alx-sousa/Autonomous-IoT-Monitoring/hardware/README.md

# Hardware

| Revision | Controller | Status and files |
|---|---|---|
| [V1](rev1/README.md) | ESP32-C6 as reported | Historical integration, peripherals, GPIO mapping and report evidence |
| [REV 2.0](rev2/README.md) | XIAO ESP32-S3 intended | Receiver PCB; schematic, board documentation, Gerbers and component matching |

The presence of fabrication files does not establish assembly, electrical validation or firmware compatibility. See the [validation status](../docs/validation.md).
