alx-sousa/Autonomous-IoT-Monitoring/docs/images/20260716_211125.jpg

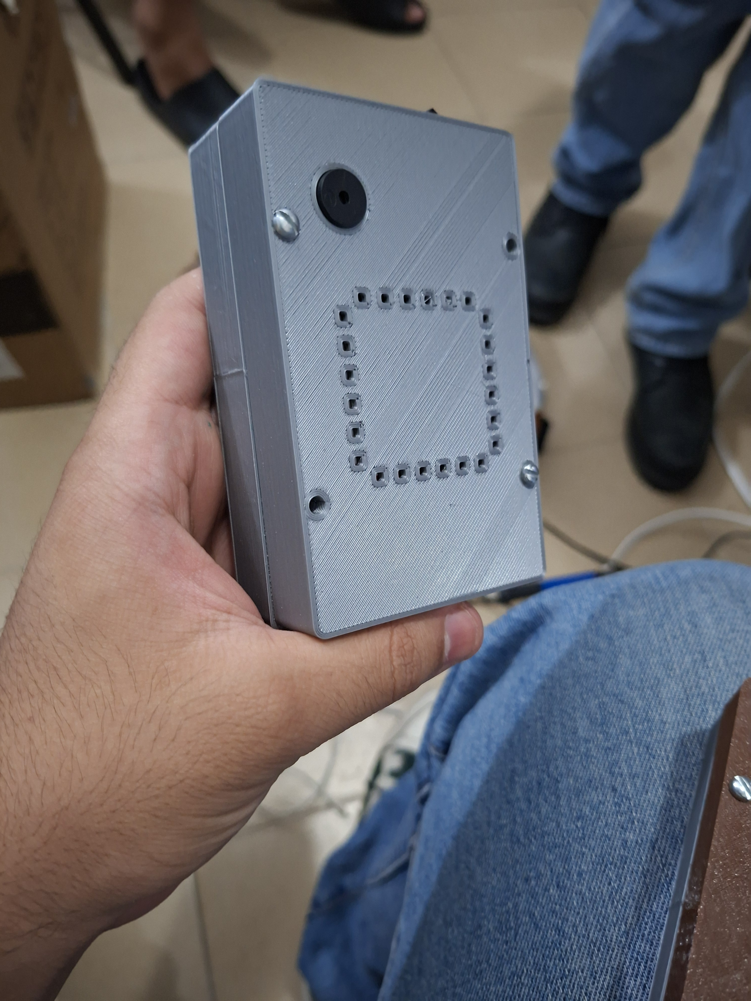
docs/images/20260716_211125.jpg
