alx-sousa/Autonomous-IoT-Monitoring/docs/images/20260716_211140.jpg

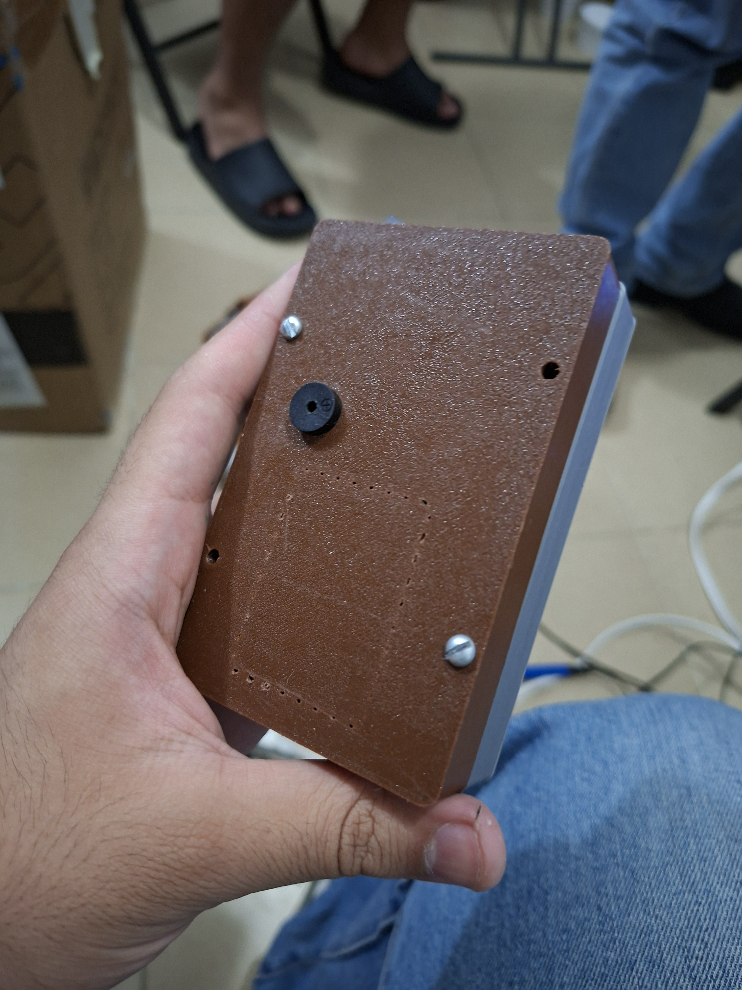
docs/images/20260716_211140.jpg
