alx-sousa/Autonomous-IoT-Monitoring/docs/images/20260717_100755~2.jpg

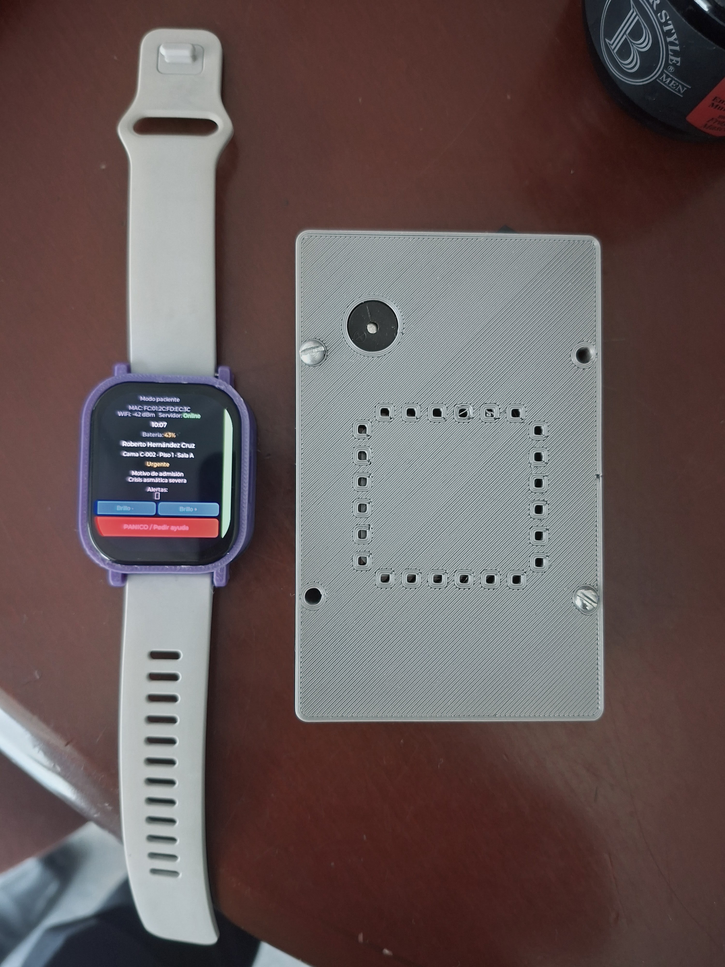
docs/images/20260717_100755~2.jpg
