alx-sousa/Autonomous-IoT-Monitoring/docs/images/architecture/system-architecture-v1-es.png

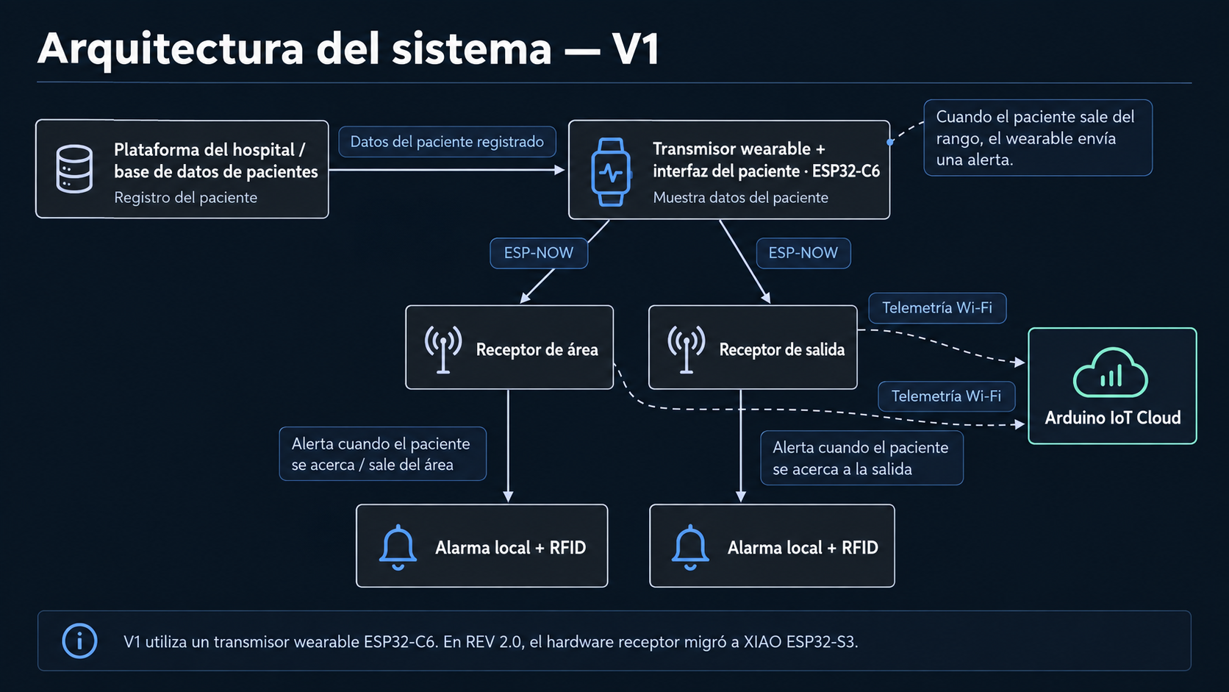
docs/images/architecture/system-architecture-v1-es.png
