alx-sousa/Autonomous-IoT-Monitoring/docs/images/rev2/pcb-bottom.png

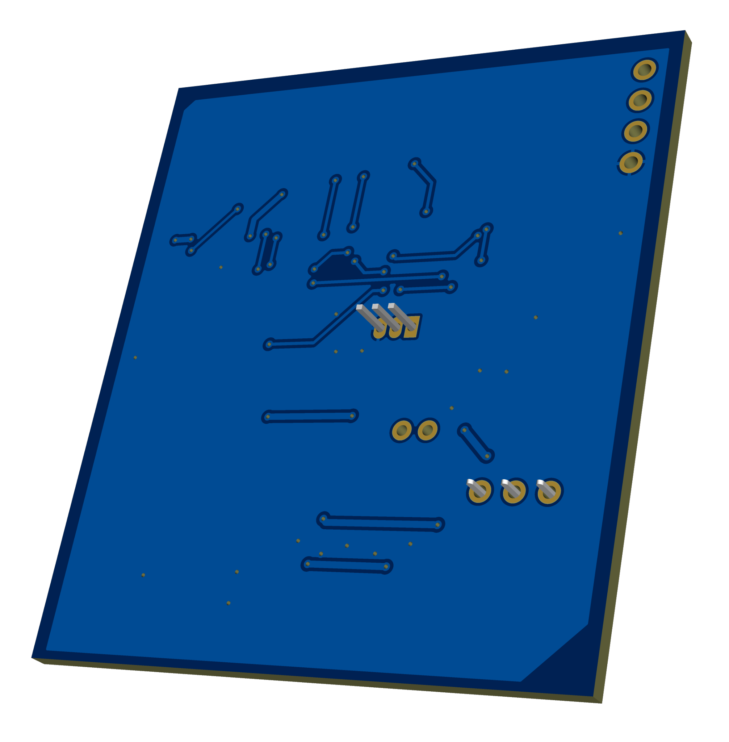
docs/images/rev2/pcb-bottom.png
