alx-sousa/Autonomous-IoT-Monitoring/hardware/rev2/bom/jlcpcb-matching-2026-09-24.xlsx

JLCPCB BOM Tool - BOM Matching
BOM name：1041c5ec480e4710936a3672ef2af2be_1790213198000-JLCPCB Assembly Order.xlsx |  |  | Download Time：2026-09-24 10:25:23 |  |  |  | * Our matching results are updated in real-time, but stock and prices may change. If it's been over 24 hours, please re-match before placing your order.
PCB Assembled Qty：5 |  |  | Est. Total Price：20.2370
Your BOM |  |  |  | Matched Parts |  |  |  |  |  |  | Order Information
Designator | Comment | Footprint | JLCPCB Part # | Matches | Part # | Manufacturer | Footprint | Description | Category | Warning | JLCPCB Part # | Product link | Lib Type | Qty | Source | Total Price ($)
BUZZER1 | 2.7kHz | BUZ-SMD_L9.0-W9.0_SMD-0955-42-27 |  | Select by System | SMD-9650-3327 | S&S | SMD,9.6x9.6mm | -20℃~+80℃ 2.7kHz 2V~5V 3.3V 30mA 5mm 80dB 9.6mm 9.6mm Active Buzzer (Built-in Driving Circuit) Electromagnetic SMD SMD,9.6x9.6mm Buzzers ROHS |  |  | C42420997 | https://jlcpcb.com/partdetail/SS-SMD_96503327/C42420997 | Extended | 5 | 5 JLCPCB | 2.1035
C1 | 100nF | C0603 |  | Select by System | 0603ZD104KAT2A | Kyocera AVX | 0603 | 100nF 10V X5R ±10% 0603 Multilayer Ceramic Capacitors MLCC - SMD/SMT ROHS | Multilayer Ceramic Capacitors MLCC - SMD/SMT |  | C1856507 | https://jlcpcb.com/partdetail/KyoceraAVX-0603ZD104KAT2A/C1856507 | Extended | 20 | 20 JLCPCB | 0.404
C2 | 10uF | C0603 |  | Select by System | 0603X106K100CT | Walsin Tech Corp | 0603 | 10uF X5R ±10% 0603 Multilayer Ceramic Capacitors MLCC - SMD/SMT ROHS | Multilayer Ceramic Capacitors MLCC - SMD/SMT |  | C2840513 | https://jlcpcb.com/partdetail/Walsin_TechCorp-0603X106K100CT/C2840513 | Extended | 20 | 20 JLCPCB | 0.988
CN1,CN3 | YTC1P-4015-01 | TESTPOINT-SMD_BD2.0-H5.5_YTC1P-4015-01 |  | Select by System | YTC1P-4015-01 | YIYUAN | SMD,D=2mm | 10000 times 100mΩ 12V 1P 2.5A 4.2mm 5.5mm Brass Gold Pogo Pin SMD,D=2mm Pogo Pin Spring Probe Connector ROHS | Pogo Pin Spring Probe Connector |  | C5221281 | https://jlcpcb.com/partdetail/YIYUAN-YTC1P_401501/C5221281 | Extended | 0 | 0 JLCPCB | 0
CN2 | PH-2AW | CONN-TH_2P-P2.00_HRO-CPH-2AW |  | Select by System | PH-2AW | Korean Hroparts Elec | 弯插,P=2mm | -25℃~+85℃ 1 1x2P 2 250V 2P 2mm 4.7mm 6.1mm 6.3mm Brass PA66 PH Right Angle Push-Pull,P=2mm Wire To Board Connector ROHS | Wire To Board Connector |  | C22360303 | https://jlcpcb.com/partdetail/Korean_HropartsElec-PH2AW/C22360303 | Extended | 5 | 5 JLCPCB | 0.2295
D1 | 1N4148W | SOD-123_L2.7-W1.6-LS3.7-FD |  | Select by System | 1N4148W | hongjiacheng | SOD-123 | -55℃~+150℃ 1.25V@150mA 100V 150mA 1uA@75V 2A 400mW 4ns Independent SOD-123 Switching Diodes ROHS | Switching Diodes |  | C7420318 | https://jlcpcb.com/partdetail/hongjiacheng-1N4148W/C7420318 | Extended | 15 | 15 JLCPCB | 0.105
OLED1 | HS91L02W2C01 | OLED-TH_L38.0-W12.0_HS91L02W2C01 |  | Select by System | HS91L02W2C01 | HS | - | 0.91 1.65V~3.3V 128x32 150cd/m2 22.384x5.584mm I2C Passive (PMOLED) SSD1306 chip White - OLED Display ROHS | OLED Display |  | C5248081 | https://jlcpcb.com/partdetail/HS-HS91L02W2C01/C5248081 | Extended | 5 | 5 JLCPCB | 11.6385
Q1 | BC547 | TO-92-3_L4.9-W3.7-P1.27-L |  | Select by System | BC547 | Jiangsu Changjing Electronics Technology Co., Ltd. | TO-92 | -55℃~+150℃ 1 NPN 100mA 100nA 150MHz 300mV 45V 625mW 6V 800 NPN Standalone TO-92 Bipolar (BJT) ROHS | Bipolar (BJT) |  | C47089404 | https://jlcpcb.com/partdetail/49277194-BC547/C47089404 | Extended | 7 | 7 JLCPCB | 0.2695
R2 | 10K | R0603 |  | Unconfirmed | 0603WAF1002T5E | UNI-ROYAL(Uniroyal Elec) | 0603 | -55℃~+155℃ 100mW 10kΩ 75V Thick Film Resistor ±1% ±100ppm/℃ 0603 Chip Resistor - Surface Mount ROHS | Chip Resistor - Surface Mount | 1.The comment (0603WAF1002T5E) of this part does not match the one (10K) provided in your BOM. Please confirm; | C25804 | https://jlcpcb.com/partdetail/26547-0603WAF1002T5E/C25804 | Basic | 5 | 5 JLCPCB | 0.009
R3,R4,R5 | 330R | R0603 |  | Unconfirmed | 0603WAF3300T5E | UNI-ROYAL(Uniroyal Elec) | 0603 | -55℃~+155℃ 100mW 330Ω 75V Thick Film Resistor ±1% ±100ppm/℃ 0603 Chip Resistor - Surface Mount ROHS | Chip Resistor - Surface Mount | 1.The comment (0603WAF3300T5E) of this part does not match the one (330R) provided in your BOM. Please confirm; | C23138 | https://jlcpcb.com/partdetail/23865-0603WAF3300T5E/C23138 | Basic | 15 | 15 JLCPCB | 0.039
R6 | 1K | R0603 |  | Unconfirmed | 0603WAF1001T5E | UNI-ROYAL(Uniroyal Elec) | 0603 | -55℃~+155℃ 100mW 1kΩ 75V Thick Film Resistor ±1% ±100ppm/℃ 0603 Chip Resistor - Surface Mount ROHS | Chip Resistor - Surface Mount | 1.The comment (0603WAF1001T5E) of this part does not match the one (1K) provided in your BOM. Please confirm; | C21190 | https://jlcpcb.com/partdetail/21904-0603WAF1001T5E/C21190 | Basic | 5 | 5 JLCPCB | 0.013
SW1 | TS-1187A-B-A-B | SW-SMD_4P-L5.1-W5.1-P3.70-LS6.5-TL_H1.5 |  | Select by System | TS-1187A-B-A-B | XKB Connection | SMD-4P,5.1x5.1mm | -30℃~+85℃ 1.5mm 1.6N 100,000 cycles 12V 5.1mm 5.1mm 50mA Gold No Round Button SPST Surface Mount,Vertical Without Bracket SMD-4P,5.1x5.1mm Tactile Switches ROHS | Tactile Switches |  | C318884 | https://jlcpcb.com/partdetail/XKBConnection-TS_1187A_B_AB/C318884 | Basic | 5 | 5 JLCPCB | 0.1025
U4 | SZYY0603RGB-B | LED-SMD_4P-L1.6-W1.5-SZYY0603RGB-B |  | Select by System | SZYY0603RGB-B | Yongyu Photoelectric | SMD | -40℃~+85℃ 0.6mm 1.5mm 1.6mm 120° G:525nm、B:470nm、R:638nm G:70mW、B:70mW、R:48mW R:1.9V~2.3V、G:2.6V~3.0V、B:2.7V~3.1V R:120mcd~180mcd、G:200mcd~392mcd、B:60mcd~85mcd R:20mA、G:20mA、B:20mA R:620nm~625nm、G:525nm~533nm、B:468nm~476nm Water Clear SMD RGB LEDs ROHS |  |  | C434430 | https://jlcpcb.com/partdetail/YongyuPhotoelectric-SZYY0603RGBB/C434430 | Extended | 10 | 10 JLCPCB | 0.314
U5,U6 | HXPM2.54-1x7PTP-YQ | HDR-SMD_7P-P2.54_HX-PM2.54-1X7P-TP-YQ |  | Select by System | HX PM2.54-1x7P TP-YQ | hanxia | SMD,P=2.54mm(交错脚) | SMD,P=2.54mm(Staggered pins) Female Headers ROHS | Female Headers |  | C42379199 | https://jlcpcb.com/partdetail/hanxia-HX_PM2_54_1x7P_TPYQ/C42379199 | Extended | 10 | 10 JLCPCB | 2.928
U7 | HXPM2.54-1x4PTP-YQ | HDR-SMD_HX-PM2.54-1X4P-TP-YQ |  | Select by System | HX PM2.54-1x4P TP-YQ | hanxia | SMD,P=2.54mm(交错脚) | -40℃~+105℃ 1 1x4P 2.54mm 3A 4P 5mm Gold Square Hole Surface Mount,Vertical Top SMD,P=2.54mm(Staggered pins) Female Headers ROHS | Female Headers |  | C42379197 | https://jlcpcb.com/partdetail/hanxia-HX_PM2_54_1x4P_TPYQ/C42379197 | Extended | 5 | 5 JLCPCB | 1.0935
U3 | SS12D00G4 | SW-TH_SS12D00G4 |  | No matches | No Part Selected
