alx-sousa/Autonomous-IoT-Monitoring/hardware/rev2/schematic/schematic-2026-09-23.pdf

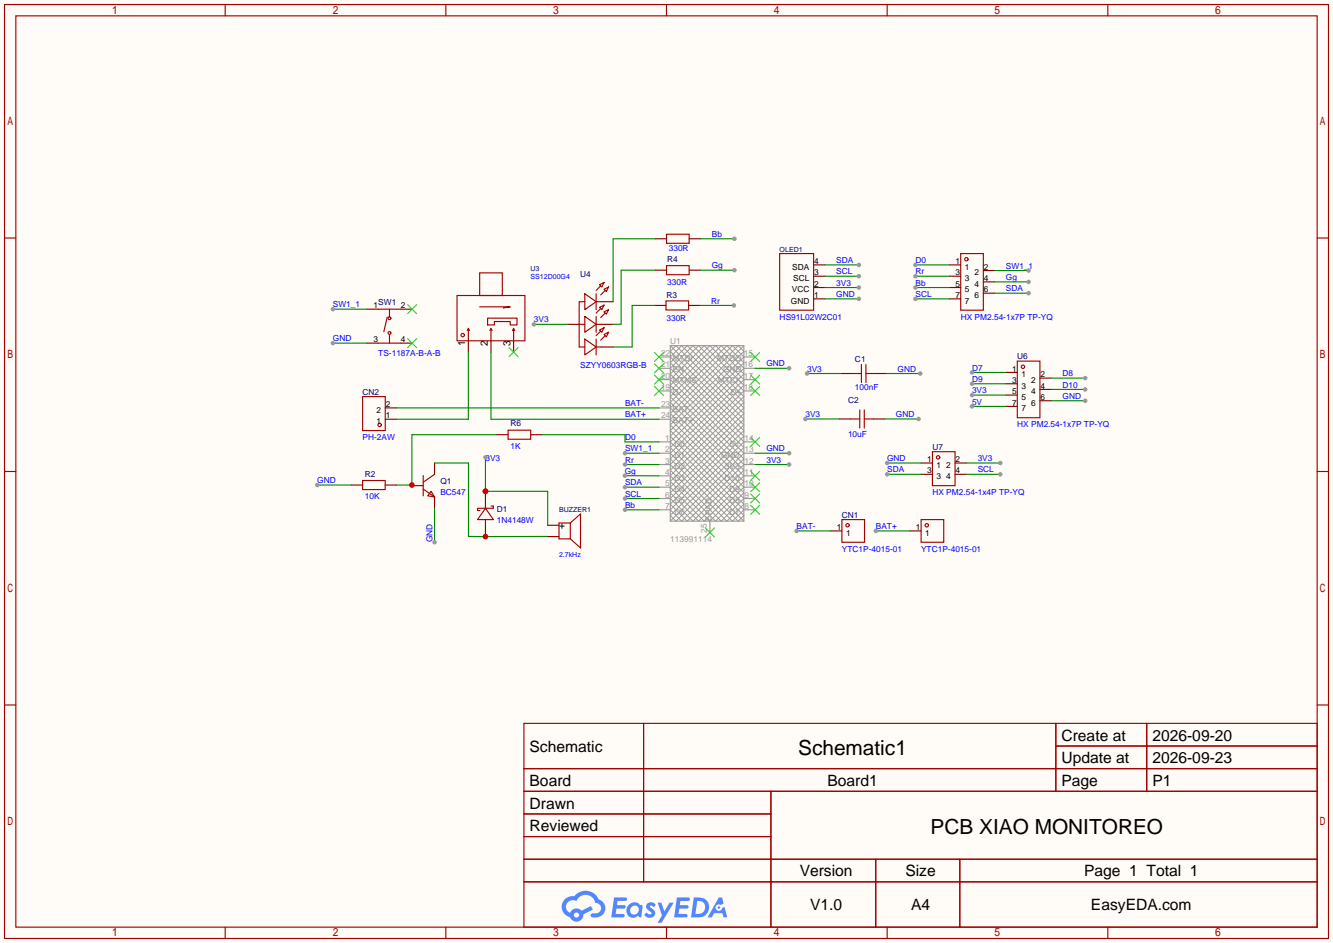
[picture p18: page 1]

Schematic | Schematic1 | Create at | 2026-09-20

Update at | 2026-09-23

Board | Board1 | Page | P1
Drawn | | PCB XIAO MONITOREO
Reviewed

Version | Size | Page 1 Total 1
V1.0 | A4 | EasyEDA.com
