alx-sousa/Autonomous-IoT-Monitoring/hardware/rev2/pcb/pcb-documentation-2026-09-23.pdf

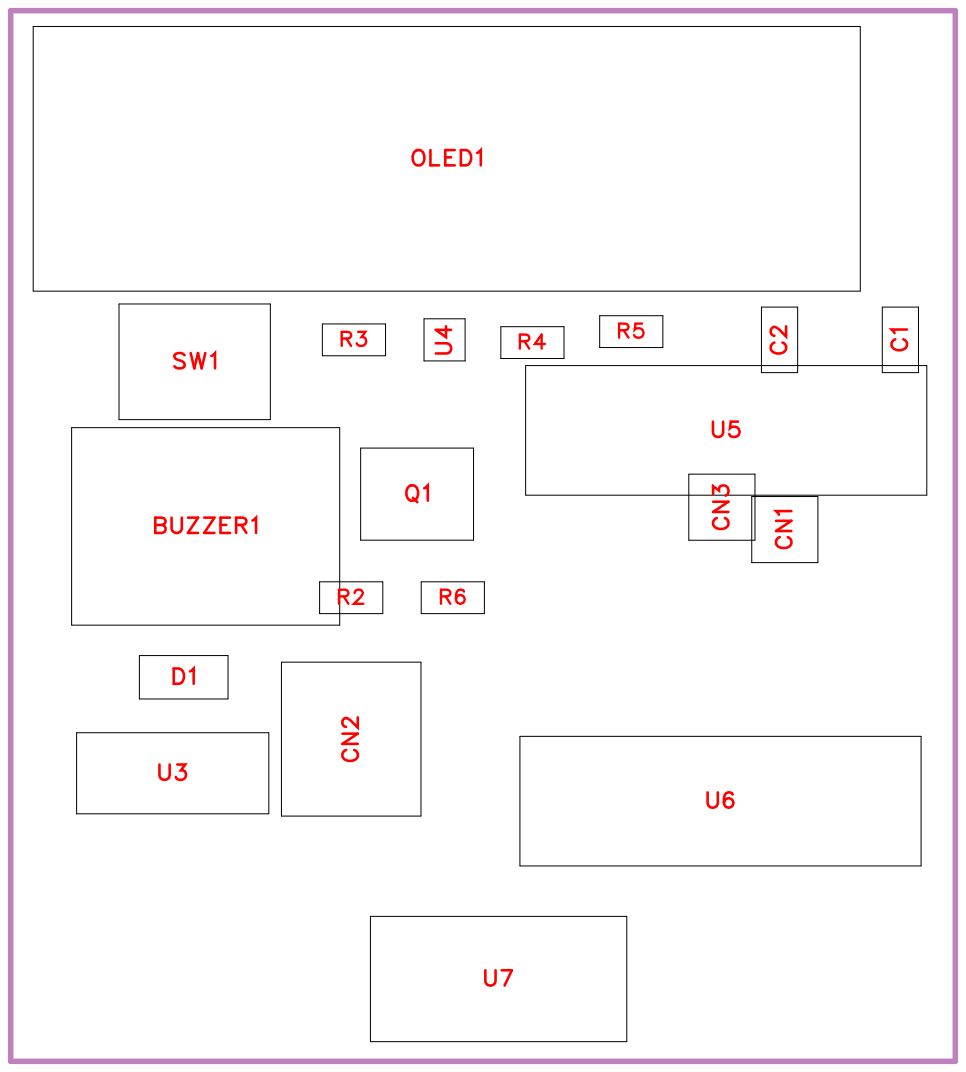
[picture p19: page 1]

No. | Quantity | Comment | Designator | Footprint | Value | Manufacturer Part | Manufacturer | Supplier Part | Supplier
1 | 1 | 2.7kHz | BUZZER1 | BUZ-SMD_L 9.0-W9.0_S MD-0955-42-27 | 2.7kHz | SMD-9650-3 327 | S&S(海旭 ) | C42420997 | LCSC
2 | 1 | 100nF | C1 | C0603 | 100nF | 0603ZD104K AT2A | Kyocera AVX | C1856507 | LCSC
3 | 1 | 10uF | C2 | C0603 | 10uF | 0603X106K1 00CT | Walsin(华新 科) | C2840513 | LCSC
4 | 2 | YTC1P-4015 -01 | CN1,CN3 | TESTPOINT-SMD_BD2.0-H5.5_YTC1P -4015-01 | | YTC1P-4015 -01 | YIYUAN(怡远 ) | C5221281 | LCSC
5 | 1 | PH-2AW | CN2 | CONN-TH_2 P-P2.00_HR O-CPH-2AW | | PH-2AW | 韩国韩荣 | C22360303 | LCSC
6 | 1 | 1N4148W | D1 | SOD-123_L2 .7-W1.6-LS3. 7-FD | | 1N4148W | R+O(宏嘉诚 ) | C7420318 | LCSC
7 | 1 | HS91L02W2 C01 | OLED1 | OLED-TH_L3 8.0-W12.0_H S91L02W2C 01 | | HS91L02W2 C01 | HS(汉昇 ) | C5248081 | LCSC
8 | 1 | BC547 | Q1 | TO-92-3_L4. 9-W3.7-P1.2 7-L | | BC547 | CJ(江苏长电 / 长晶 ) | C47089404 | LCSC
9 | 1 | 10K | R2 | R0603 | 10K
10 | 3 | 330R | R3,R4,R5 | R0603 | 330R
11 | 1 | 1K | R6 | R0603 | 1K
12 | 1 | TS-1187A-B-A-B | SW1 | SW-SMD_4P -L5.1-W5.1-P 3.70-LS6.5-T L_H1.5 | | TS-1187A-B-A-B | XKB Connect ion(中国星坤 ) | C318884 | LCSC
13 | 1 | SS12D00G4 | U3 | SW-TH_SS1 2D00G4 | | SS12D00G4 | YIZHI(逸致 ) | C50377148 | LCSC
14 | 1 | SZYY0603R GB-B | U4 | LED-SMD_4 P-L1.6-W1.5-SZYY0603R GB-B | | SZYY0603R GB-B | yongyu(永裕 光电 ) | C434430 | LCSC
15 | 2 | HX PM2.54-1x7P TP-YQ | U5,U6 | HDR-SMD_7 P-P2.54_HX-PM2.54-1X7 P-TP-YQ | | HX PM2.54-1x7P TP-YQ | hanxia(韩下 ) | C42379199 | LCSC
16 | 1 | HX PM2.54-1x4P TP-YQ | U7 | HDR-SMD_H X-PM2.54-1X 4P-TP-YQ | | HX PM2.54-1x4P TP-YQ | hanxia(韩下 ) | C42379197 | LCSC

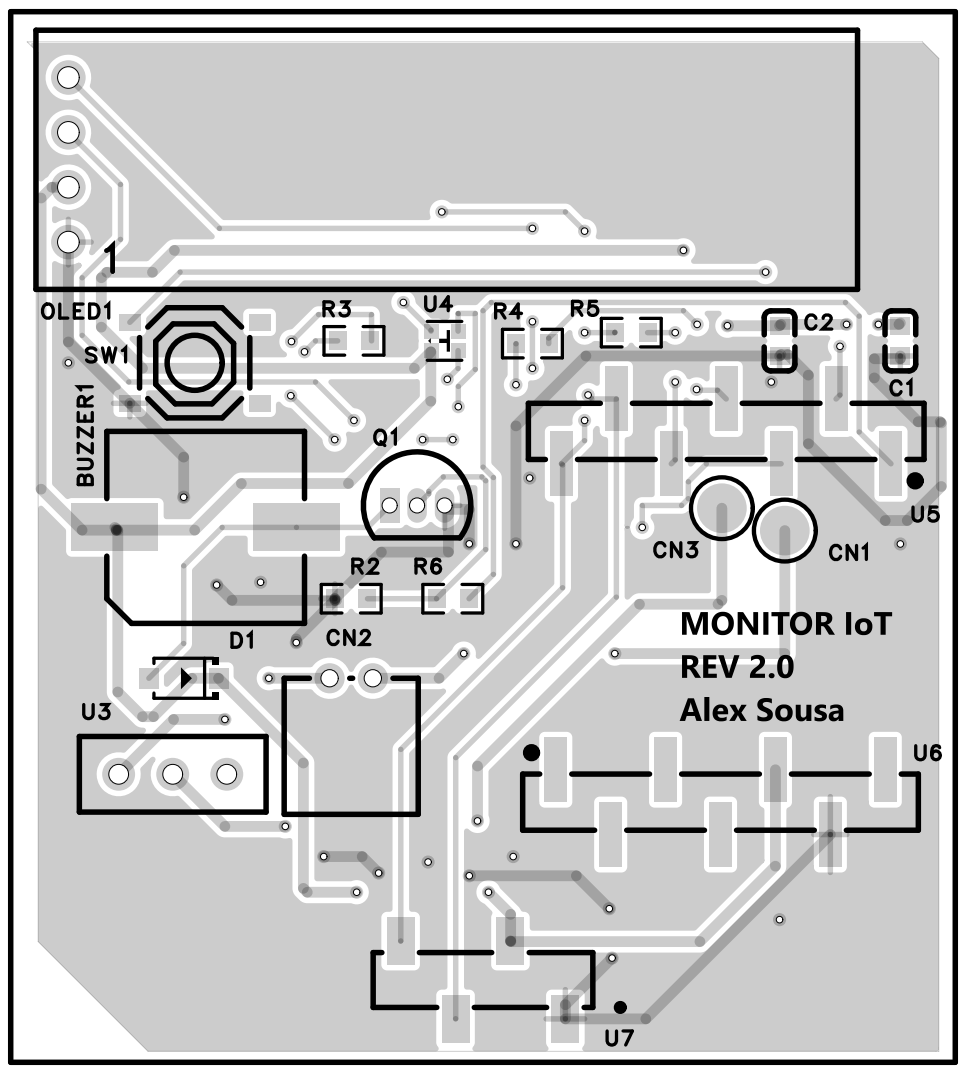
[picture p20: page 4]

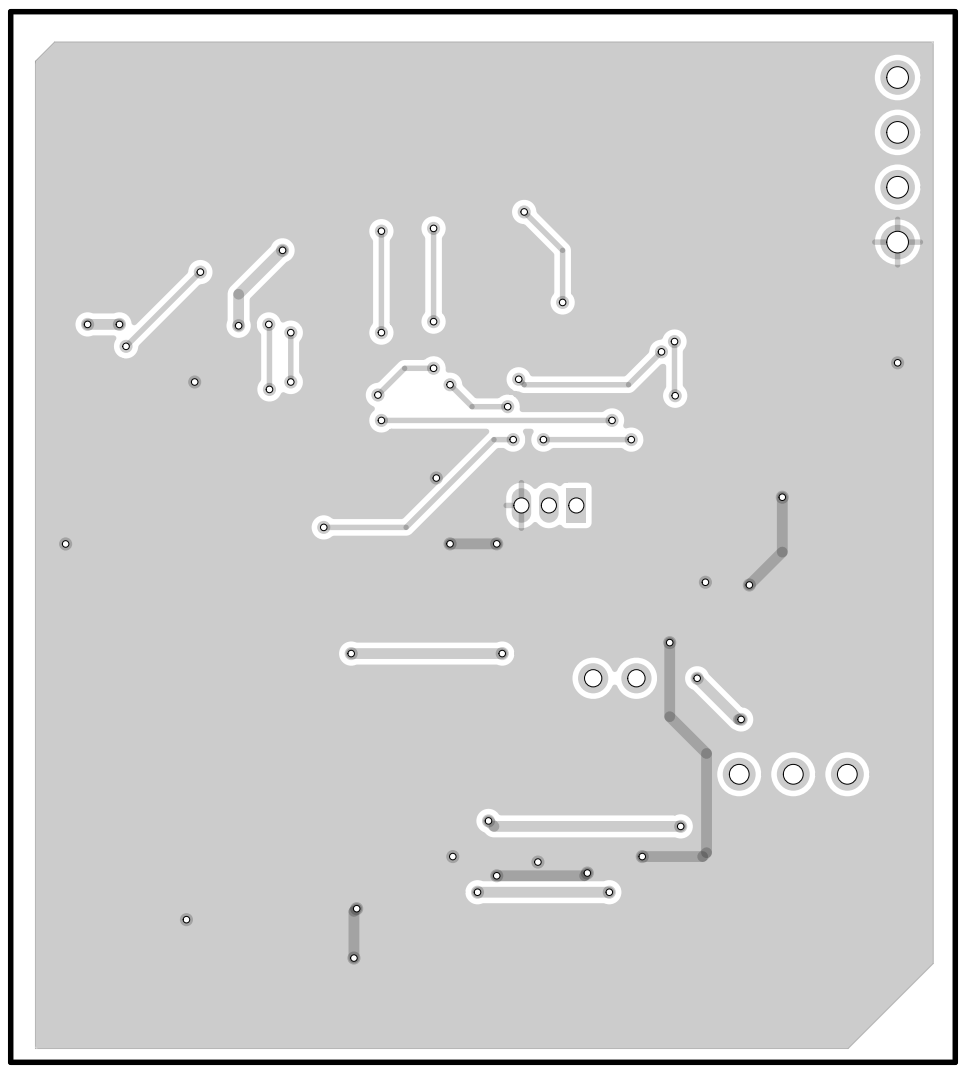
[picture p21: page 5]

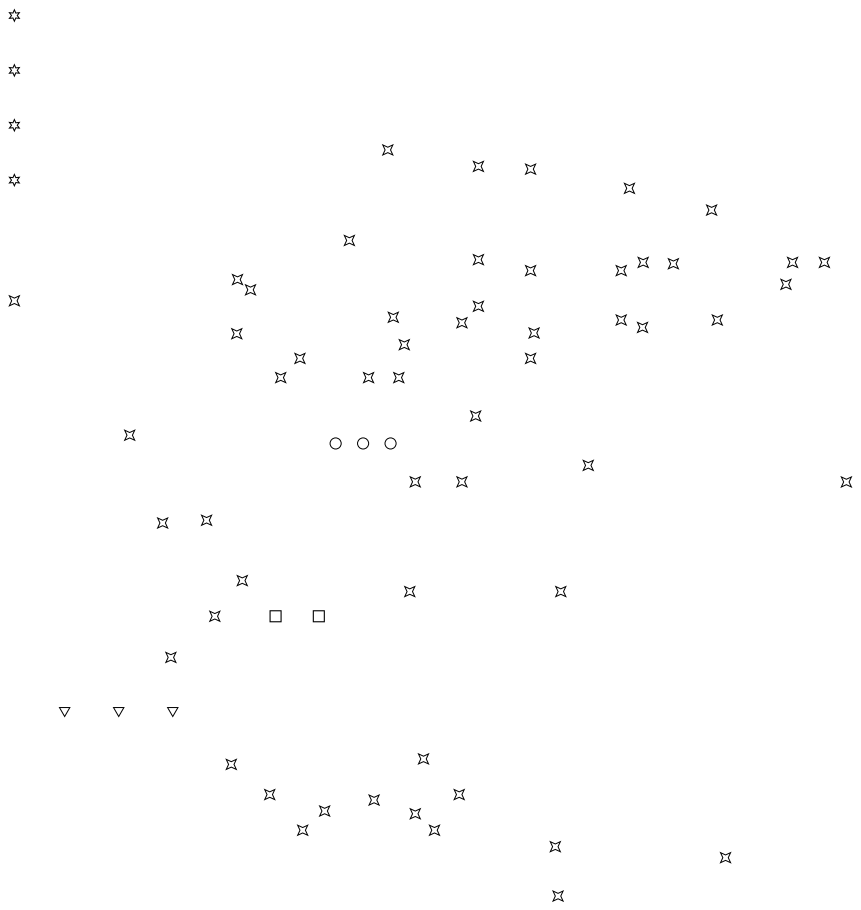
[picture p22: page 6]
