alx-sousa/Autonomous-IoT-Monitoring/(commit log)

2026-09-20 docs: add measured prototype testing results
2026-09-20 docs: add hardware BOM and connection reference
2026-09-20 docs: add integrated prototype gallery
2026-09-23 docs: present V1 engineering portfolio with residency evidence
    Refresh Spanish README and add English overview, objectives, design decisions,
    setup instructions and a source-aware review of reported results.
    Add six technical figures; preserve all original prototype images.
    Consolidate firmware, remove credential-bearing root duplicates and restore
    the missing Cloud connection declaration. Document credential rotation.
2026-09-24 docs: add rev2 hardware artifacts and engineering documentation
    [jlcpcb-matching-2026-09-24.xlsx]
2026-09-25 Reframe historical testing around delivered V1 prototype
2026-09-26 docs: document REV 2.0 Fusion assembly in Spanish
2026-09-26 docs: add Fusion 360 mechanical assembly decisions
2026-09-26 docs: add REV 2.0 mechanical assembly evidence notes
2026-09-26 docs: link REV 2.0 PCB hardware portfolio
2026-09-26 docs: add REV 2.0 Fusion 360 assembly visual
2026-09-26 docs: add Fusion 360 assembly visual to Spanish README
2026-09-26 docs: include Fusion 360 mechanical assembly evidence
2026-09-27 docs: add final REV 2.0 enclosure CAD
2026-09-27 docs: mark REV 2.0 enclosure CAD complete
2026-09-27 docs: document completed REV 2.0 enclosure CAD
2026-09-27 docs: close REV 2.0 mechanical CAD stage
2026-09-27 docs: add final REV 2.0 enclosure CAD evidence
2026-09-27 docs: update REV 2.0 mechanical CAD status
2026-09-27 chore: remove incorrect REV 2.0 enclosure CAD image
2026-09-27 chore: rename final REV 2.0 enclosure CAD image
2026-09-27 docs: fix final REV 2.0 enclosure CAD image path
2026-09-28 docs: highlight wearable transmitter patient interface
2026-09-28 Rename Imagen de ChatGPT 27 sept 2026, 10_58_44 p.m..png to wearable-transmitter-v1.jpg
2026-09-28 docs: replace public firmware source with block-level architecture
    [transmitter.ino]
2026-10-20 docs: document V1 transmitter control flow
2026-10-20 docs: surface firmware review in Spanish landing page
