alx-sousa/Autonomous-IoT-Monitoring/docs/images/20260716_211158.jpg

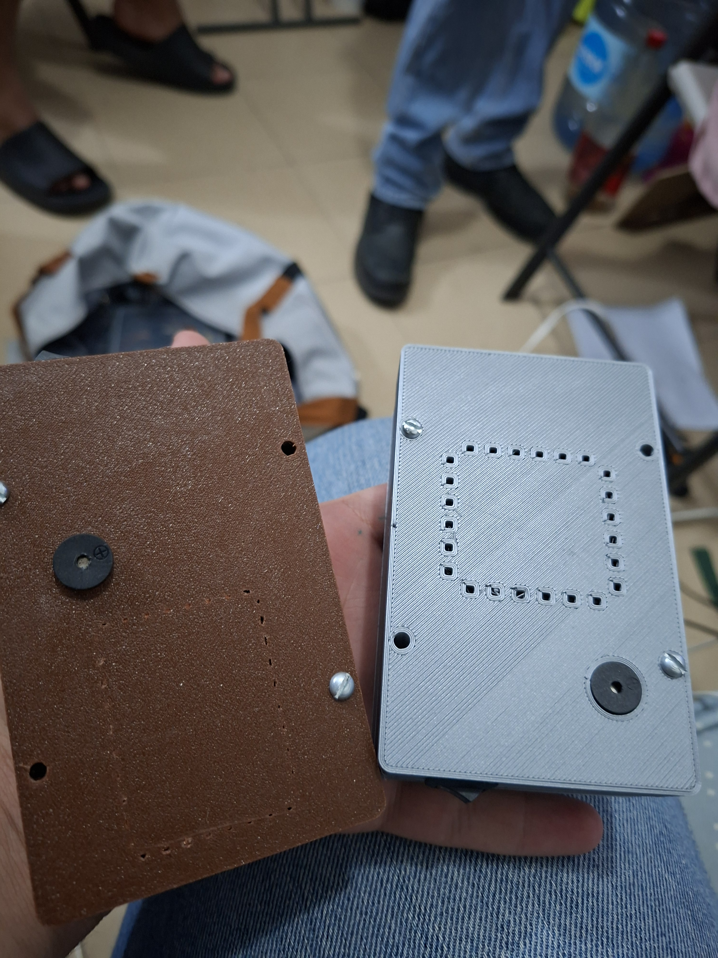
docs/images/20260716_211158.jpg
